Arrogantyunya/Multiple_film_roll_controllerV1.0/一拖多卷膜机控制箱电气原理图.pdf

32C

24V+

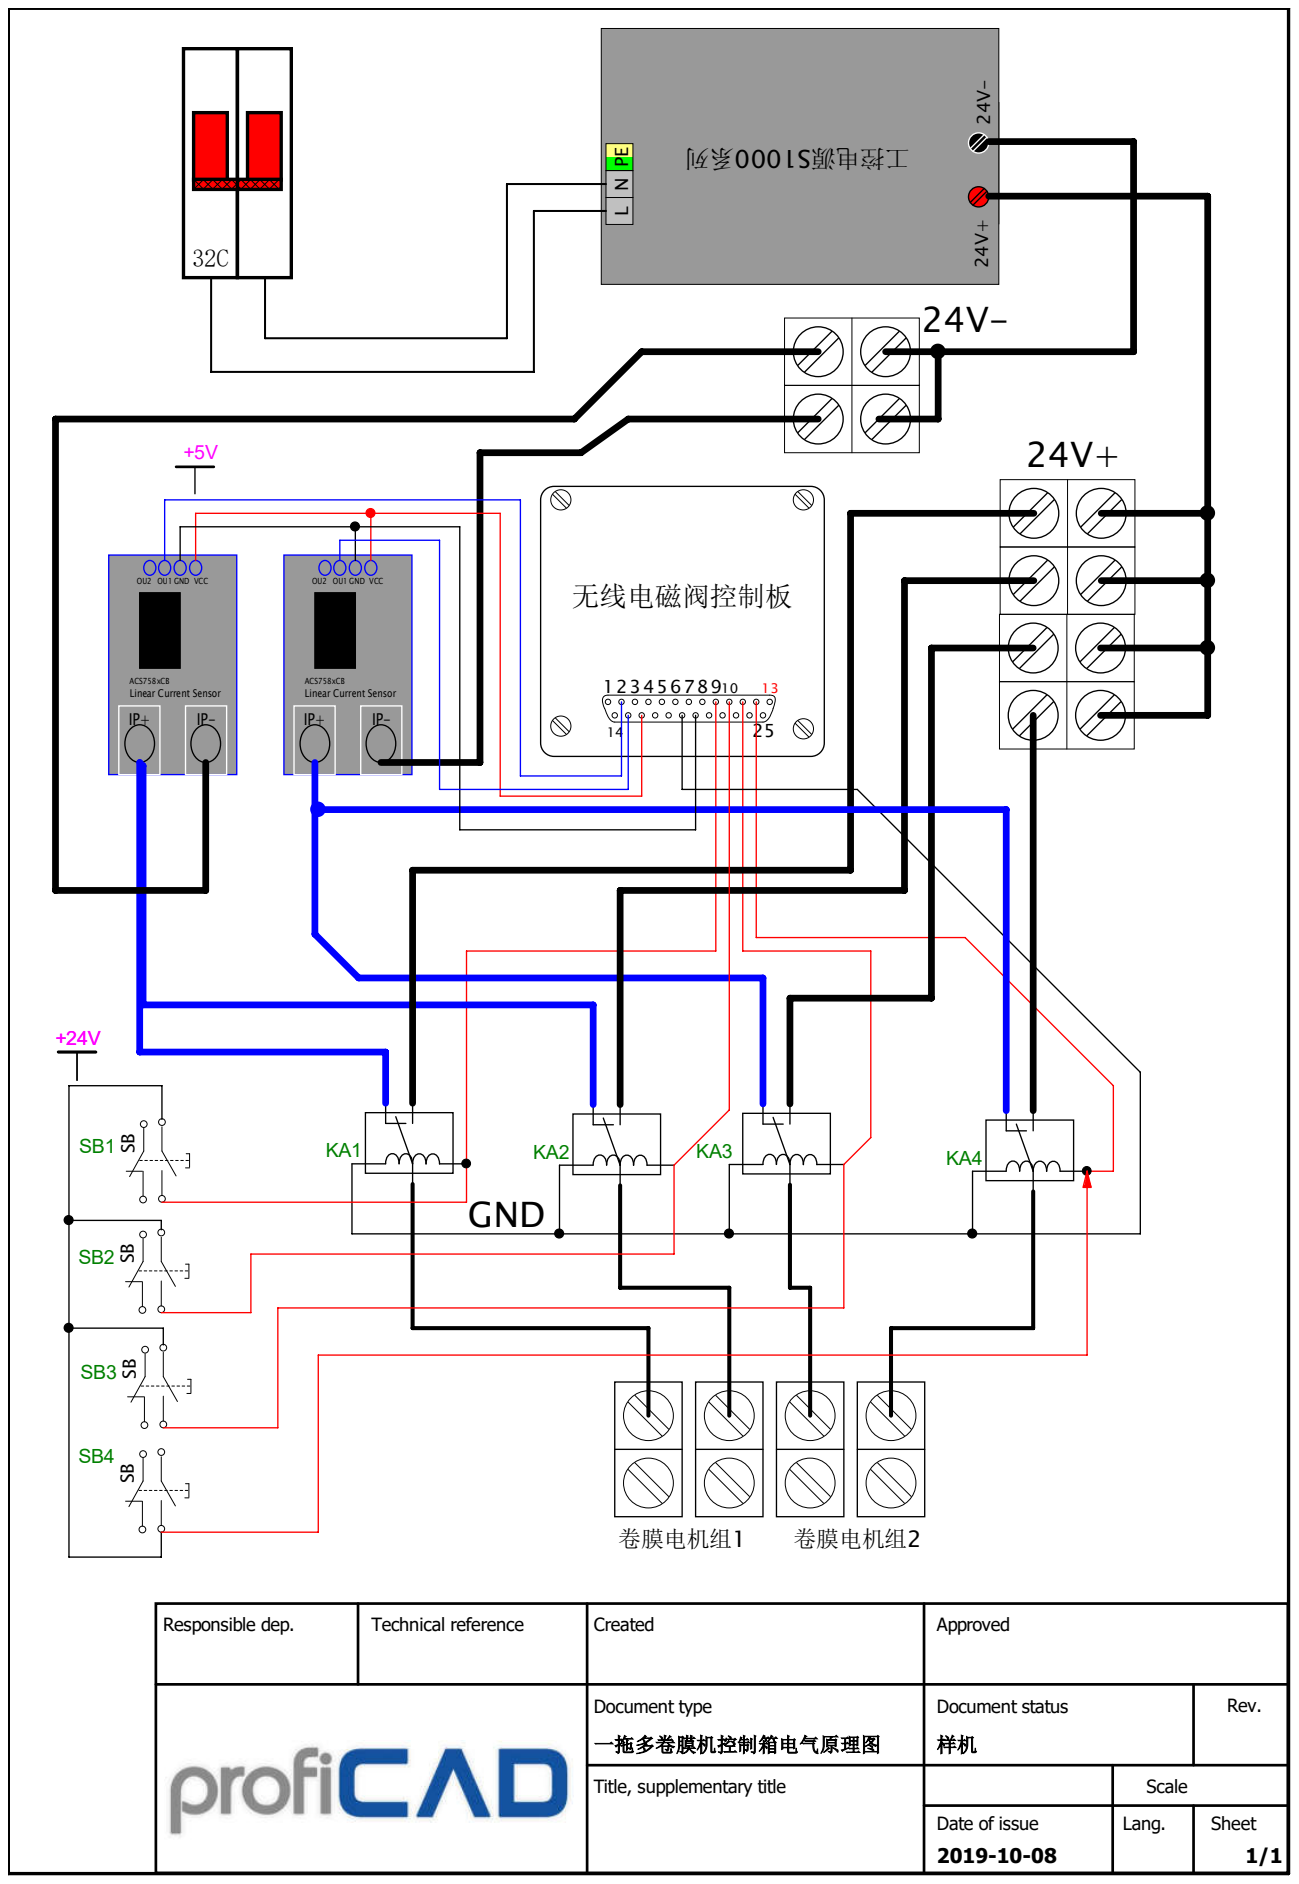
[picture p1: page 1]
无线电磁阀控制板; OU2 OU1 GND VCC; 卷膜电机组1; 卷膜电机组2; GND; Responsible dep.; Technical reference; Created; Approved

ACS758xCB
Linear Current Sensor

Document type 一拖多卷膜机控制箱电气原理图 | Document status 样机 | Rev.

Title, supplementary title | | Scale

Date of issue 2019-10-08 | Lang. | Sheet 1/1
