Arrogantyunya/Multiple_film_roll_controllerV1.0/电流电压检测型卷膜机V2.0.1_alpha/LoRa_Roll_Film/BCD_CON.h

#ifndef _BCD_CON_H
#define _BCD_CON_H

void ToBCD(int n,unsigned char *p1,unsigned char *p0,unsigned char *flag);
//unsigned int BCDToInt(unsigned char byte1,unsigned char byte0);
//int TD_ASC2BCD(unsigned char *bcd, const char *asc,int len,int fmt );
void FloatStringToIntString(char *fstring,char *Istring,unsigned char *NumOfDot,int sringLen);
//unsigned int ASC2BCD(char *bcd, char *asc, int len);
unsigned int ASC2BCD(unsigned char *bcd, char *asc, unsigned int len); 
unsigned int  BCD2ASC ( char  *asc,char *bcd,int len);
void ulongtoString(char buffer[], long a);
extern unsigned int  BCDtoDec(unsigned char *bcd, int length);
unsigned int inttoBCD(int m);  
unsigned char ByteTOBcd(unsigned char OneByte);
void PackBCD(char* buff, float value, int width, int decimal);
float UnPackBCD(char* buff, int width, int decimal);   

#endif
