Arrogantyunya/Multiple_film_roll_controllerV1.0/电流电压检测型卷膜机V2.0.1_alpha/LoRa_Roll_Film/Private_RTC.h

#ifndef _PRIVATE_RTC_H
#define _PRIVATE_RTC_H

#include <RTClock.h>

class date{
public:
    void Update_RTC(unsigned char *buffer);
    void Get_RTC(unsigned char *buffer);
};

extern date Private_RTC;

#endif
