Arrogantyunya/Multiple_film_roll_controllerV1.0/电流电压检测型卷膜机V2.0.1_alpha/LoRa_Roll_Film/receipt.h

#ifndef _RECEIPT_H
#define _RECEIPT_H

#include <Arduino.h>

#define DEVICE_TYPE_ID  0xC001

#define SOFT_VERSION    0x14 //V2.0

#define HARD_VERSION    0x53//V8.3

enum ReceiptStatus{
  FactoryMode = 0, AskUploadParamsOk, AskUploadParamsErr, AssignGroupIdArrayOk, AssignGroupIdArrayErr, SetSnAndSlaverCountOk, 
  SetSnAndSlaverCountErr, TrunOffOk, TrunOffErr, RestRollerOk, ResetRollerErr, OpenRollerOk, OpenRollerErr, LimitRollerOk,
  LimitRollerErr, SetLoRaModeOk, SetLoRaModeErr
};

/*电机状态*/
enum MotorStatus{
  MotorFactoryMode = 0, ROLL_OK, HIGH_POSITION_LIMIT_EXCEPTION, LOW_POSITION_LIMIT_EXCEPTION, LOW_POWER, MOTOR_EXCEPTION, MOTOR_CURRENT_EXCEPTION, 
  ROLLING, CMD_EXCEPTION, NOT_INITIALIZED, STORE_EXCEPTION, RESET_ROLLING, RESET_ROLLOK, RS485_EXCEPTION, FORCE_STOP, MANUAL_ROLL_OK, MANUAL_KEY_EXCEPTION, 
  OPEN_ROLL_ERROR
};

extern unsigned char gMotorStatus;

/*
 @brief   : 设置当前设备工作状态
 @para    : 设备状态
 @return  : 无
*/
inline void Set_Motor_Status(unsigned char status) {gMotorStatus = status;}

/*
 @brief   : 读取当前设备工作状态
 @para    : None
 @return  : 设备状态       
*/
inline unsigned char Read_Motor_Status(void) {return (gMotorStatus);}

class Receipt{
public:
    void Report_General_Parameter(void);
    void Request_Set_Group_Number(void);
    void Request_Device_SN_and_Channel(void);
    void Working_Parameter_Receipt(bool use_random_wait, unsigned char times);
    void General_Receipt(unsigned char status, unsigned char send_times);
private:
  void Receipt_Random_Wait_Value(unsigned long int *random_value);
  void Clear_Server_LoRa_Buffer(void);
  void Print_Debug(unsigned char *base_addr, unsigned char len);
};

extern Receipt Message_Receipt;

#endif
