Arrogantyunya/Multiple_film_roll_controllerV1.0/(commit log)

2019-12-17 多路LORA卷膜机2019-12-17
2019-12-20 增加了部分注释
